vpodlesnyi/eGAN-FET-module/README.md

# eGAN-FET-module
Control driver module with implemented Gallium Nitride MOSFET transistors.
