vpodlesnyi/eGAN-FET-module/OUTPUT/BOM/Bill of Materials-eGAN-FET-module.xlsx

Part Name | Part Number | Value | Voltage | Quantity | Total | 2 | Ordered
Ceramic | GRM31C5C2A104JA01L | 0,1мк | 100В | 3 | 6 |  | 10
Ceramic | GRM155R71H104KE14D | 0,1мк | 50В | 22 | 44 |  | 100
Ceramic | GRM1555C1H102J | 1000 | 50B | 4 | 8 |  | 100
MLCC | EMK105BJ105KV-F | 1мк | 16B | 12 | 24 |  | 100
Bidirectional, Ultra-Precise Current Sense Amplifier | INA240A1D |  |  | 4 | 8 |  | 8
Low-Drift, Low-Power, Dual-Output, Voltage References | REF1933AIDDCT |  |  | 3 | 6 |  | 6
Half Bridge GaN Driver with Integrated Bootstrap Diode | LMG1205YFXR |  |  | 4 | 8 |  | 8
Resistor | RC0402FR-07100KL | 100к |  | 1 | 2 |  | 100
Current Sense Resistors | CRE2512-FZ-R003E-3 | 0.003 |  | 6 | 12 |  | 12
Current Sense Resistors | ERJ-8CWFR036V | 0.036 |  | 1 | 2 |  | 5
Resistor | RC0402FR-079K1 | 9,1к |  | 1 | 2 |  | 100
Resistor | RC0402FR-071KL | 1к |  | 4 | 8 |  | 100
Resistor | RC0402FR-07100RL | 100 |  | 14 | 28 |  | 100
Resistor | RC0402FR-0710KL | 10к |  | 14 | 28 |  | 100
Resistor | RC0402FR-075R1L | 5,1 |  | 7 | 14 |  | 100
Resistor | RC0402FR-071RL | 1 |  | 7 | 14 |  | 100
Resistor | RC0402FR-070RL | 0 |  | 2 | 4 |  | 100
General Purpose Diodes | 1N4448WQ-7-F |  |  | 1 | 2 |  | 5
 | EPC2016C |  |  | 7 | 14 |  | 8 | 6 с элитана | 2 с чип дипа
 | PMCXB900UELZ |  |  | 7 | 14 |  | 14
PLS-2 |  |  |  | 7 | 14
3 отверстия под запайку |  |  |  | 4 | 8
PLS-3 | DS1021-1*3SF112-B |  |  | 3 | 6
Resistor | RC0402FR-076K8 | 6,8к |  | 1 | 2 |  | 100
