vpodlesnyi/eGAN-FET-module/OUTPUT/STEP/eGAN-FET-module.step

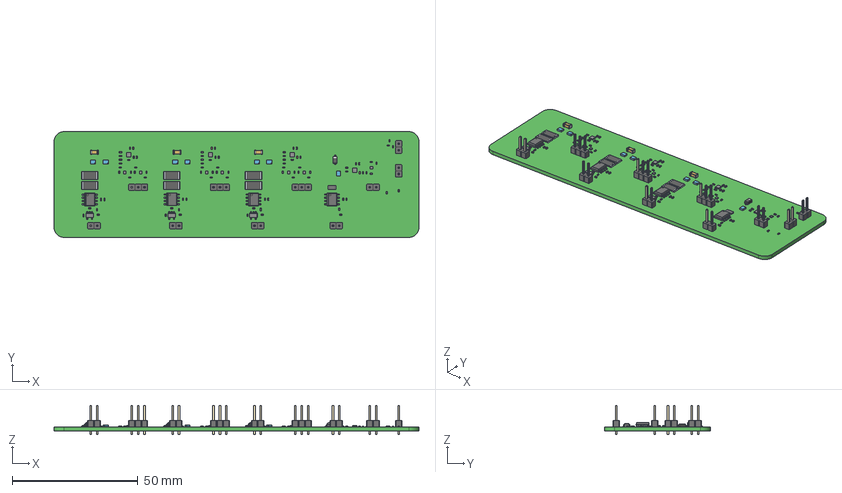
[picture p1: CAD file, 2022-06-16]
OUTPUT/STEP/eGAN-FET-module.step
145.0 x 42.0 x 11.5 mm
User_Library-PLS-2 x 7
User_Library-PLS-3 x 3
User_Library-R_0402 x 50
PMCXB900UELZ x 7
Extruded x 7
CircuitWorks-SOD123
User_Library-R2512-1 x 6
User_Library-res1206-1
SOIC-8 x 4
User_Library-SOT23-5-3_Free-Models003 x 3
User_Library-SOT23-5-3_Fusion x 3
User_Library-C0402-1 x 38
SMD_1206 x 3
