vpodlesnyi/eGAN-FET-module/OUTPUT/SCH/eGAN-FET-module.PDF

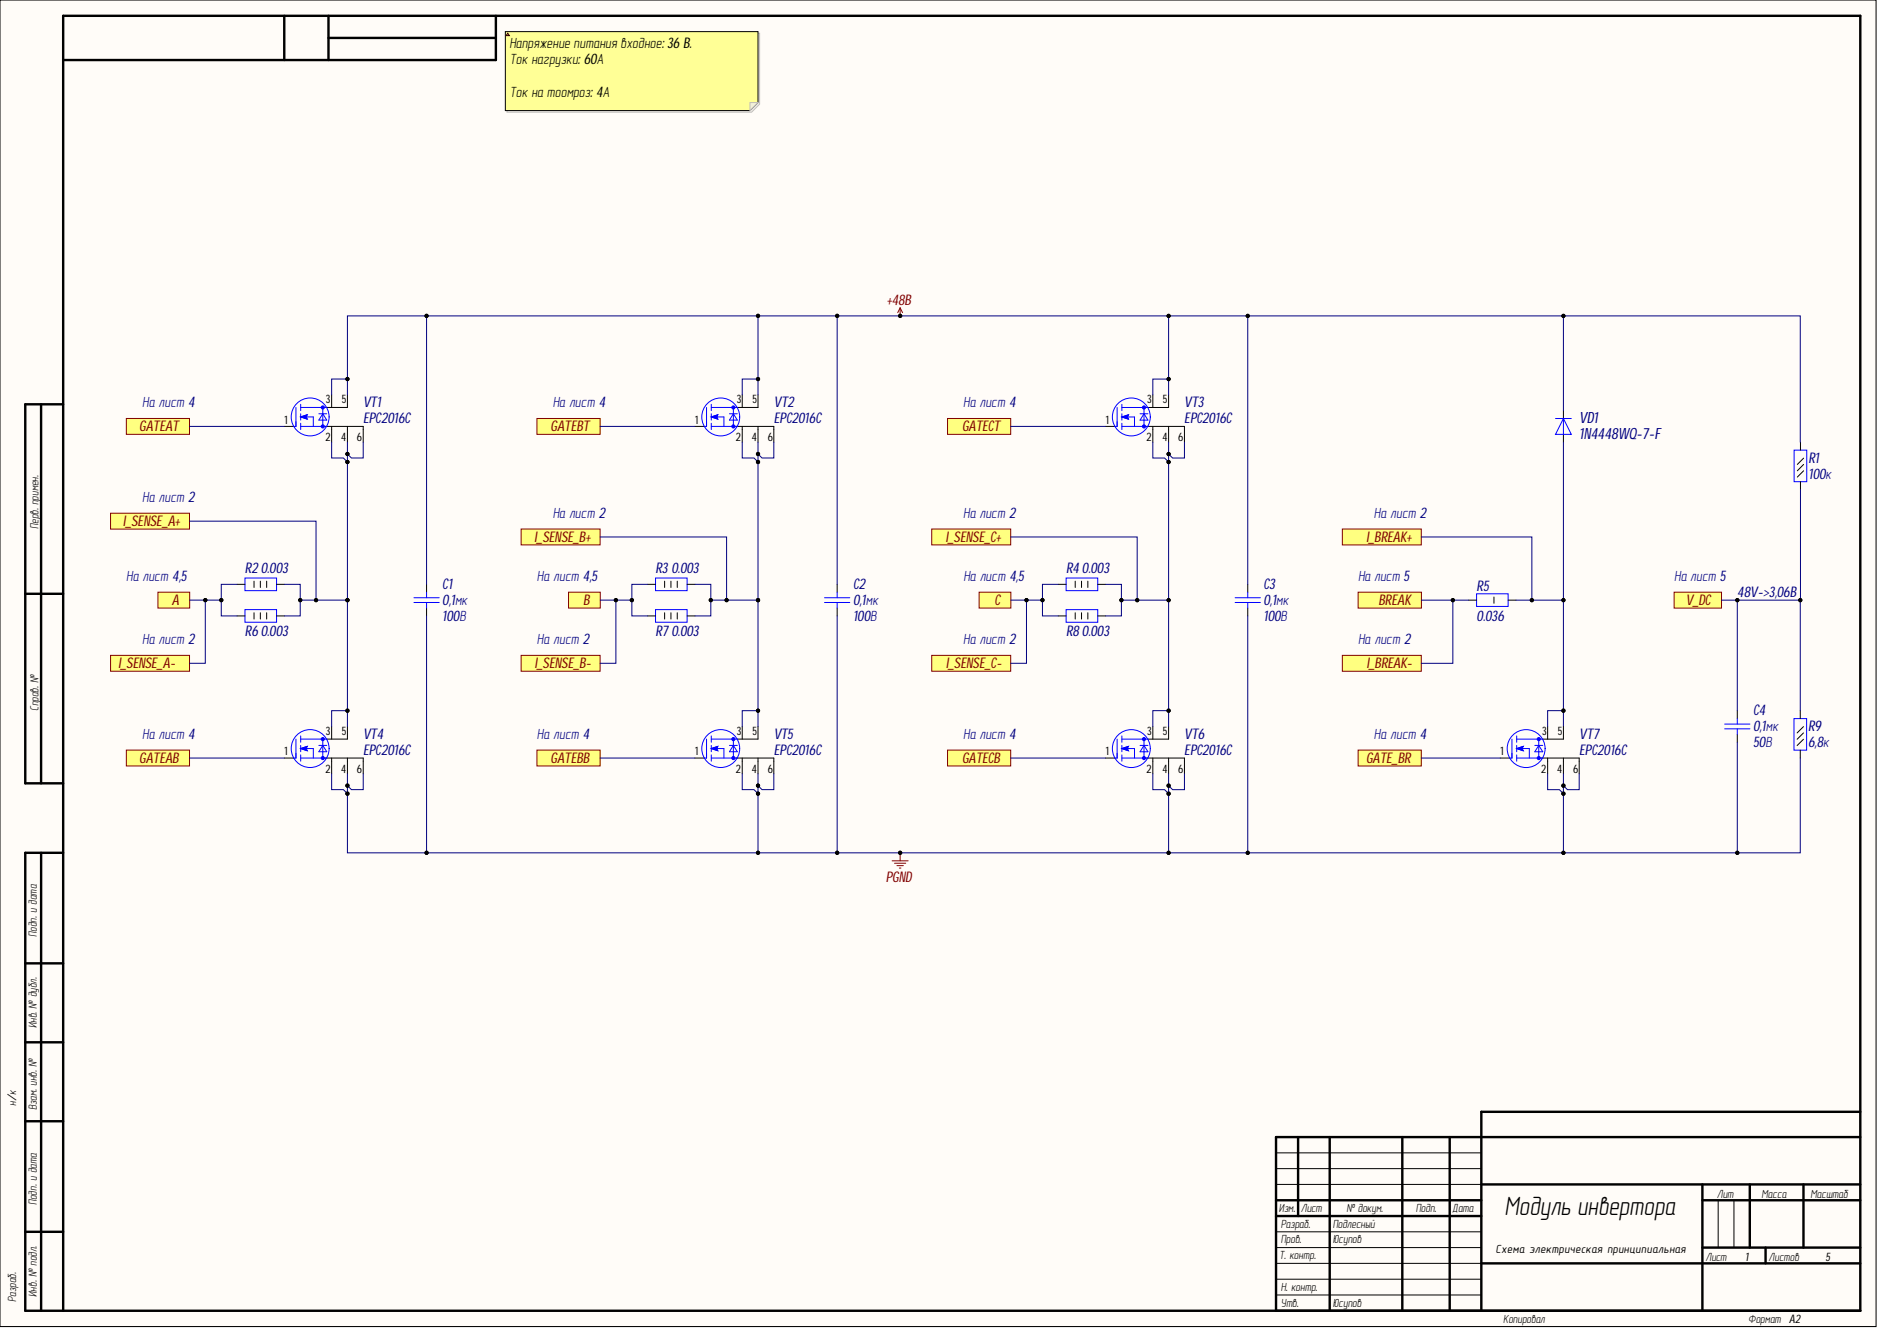
[picture p2: page 1]

Инв. № подл. Инв. № дубл. Подп. и дата Взам. инв. № Подп. и дата Перв. примен. Справ. №

Изм . | Лис т | № докум . | Подп . | Дат а | | | ит | Масса | Масштаб 1

Модуль инвертора Схема электрическая принципиальная | Л

Разраб . | | Подлесный
Пров . | | Юсупов
Т. контр . | | | | | Лис т | Листов

Н. контр .
Утв . | Юсупов

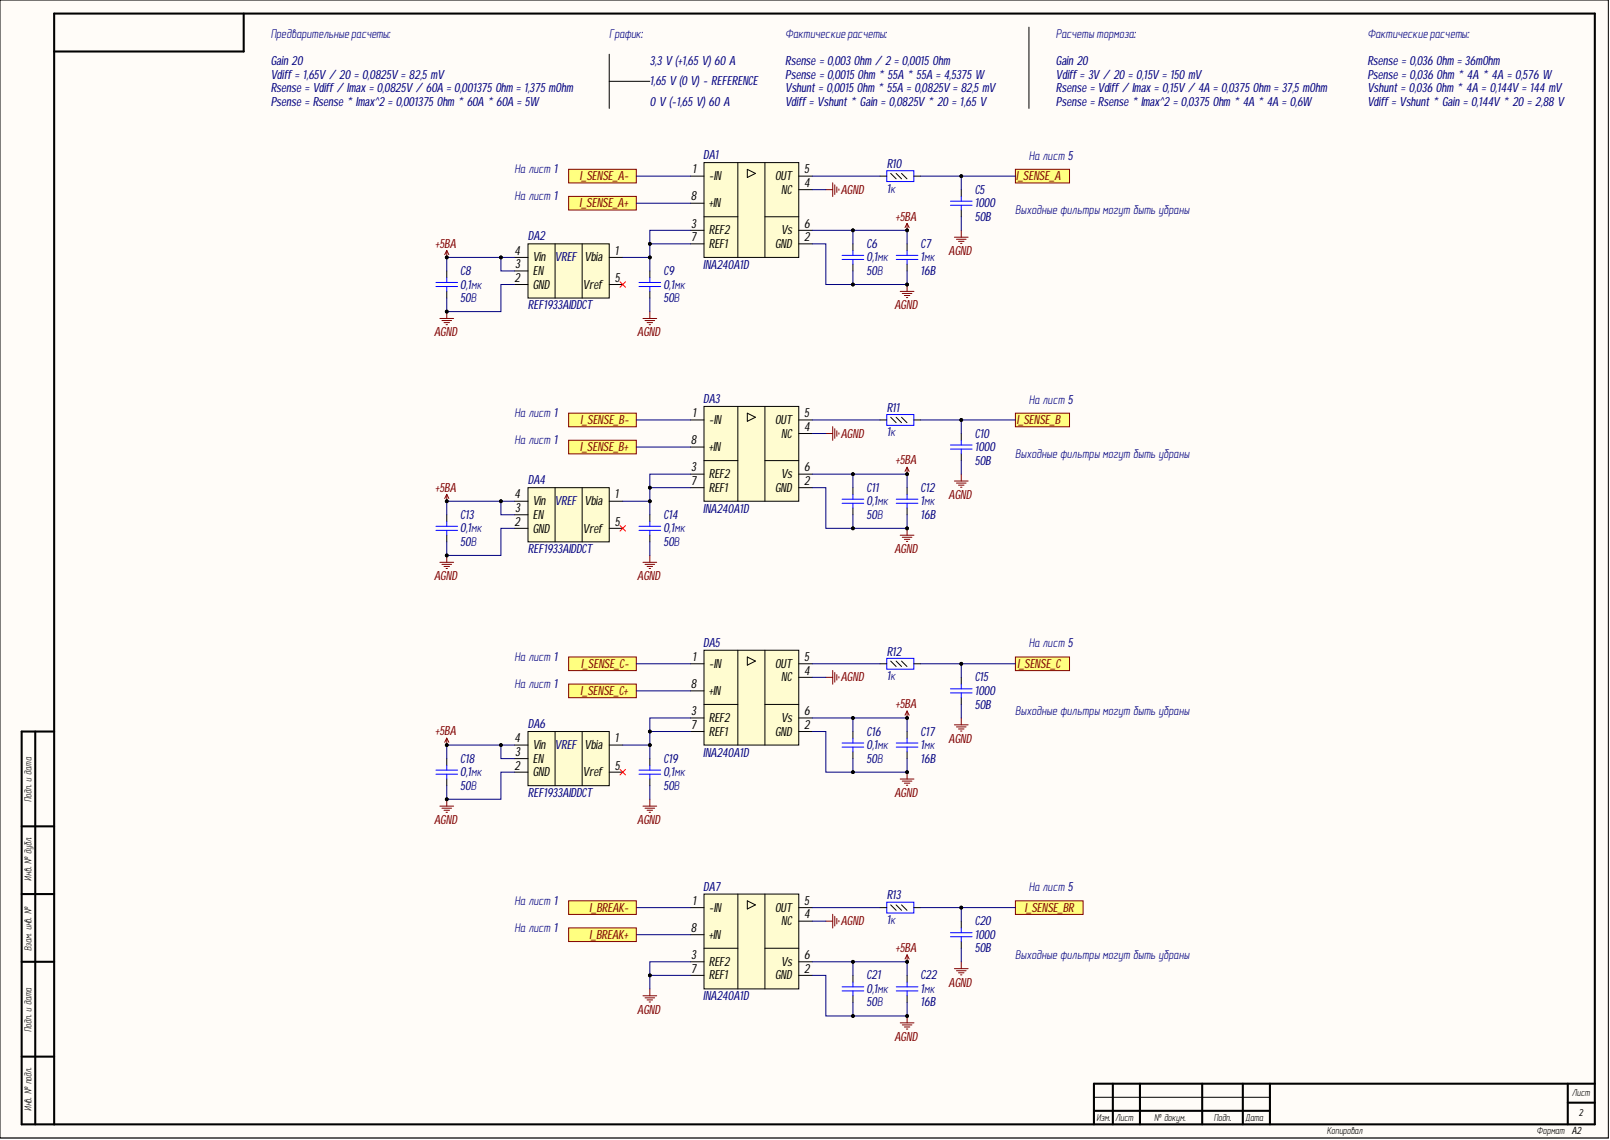
[picture p3: page 2]

Gain 20
Vdiff = 1,65V / 20 = 0,0825V = 82,5 mV
Rsense = Vdiff / Imax = 0,0825V / 60A = 0,001375 Ohm = 1,375 mOhm

Vdiff = 3V / 20 = 0,15V = 150 mV
Rsense = Vdiff / Imax = 0,15V / 4A = 0,0375 Ohm = 37,5 mOhm
Psense = Rsense * Imax^2 = 0,0375 Ohm * 4A * 4A = 0,6W

DA1 | На лист 5
-IN 1

Выходные фильтры могут быть убраны

Инв. № подл. Инв. № дубл. Подп. и дата Взам. инв. №

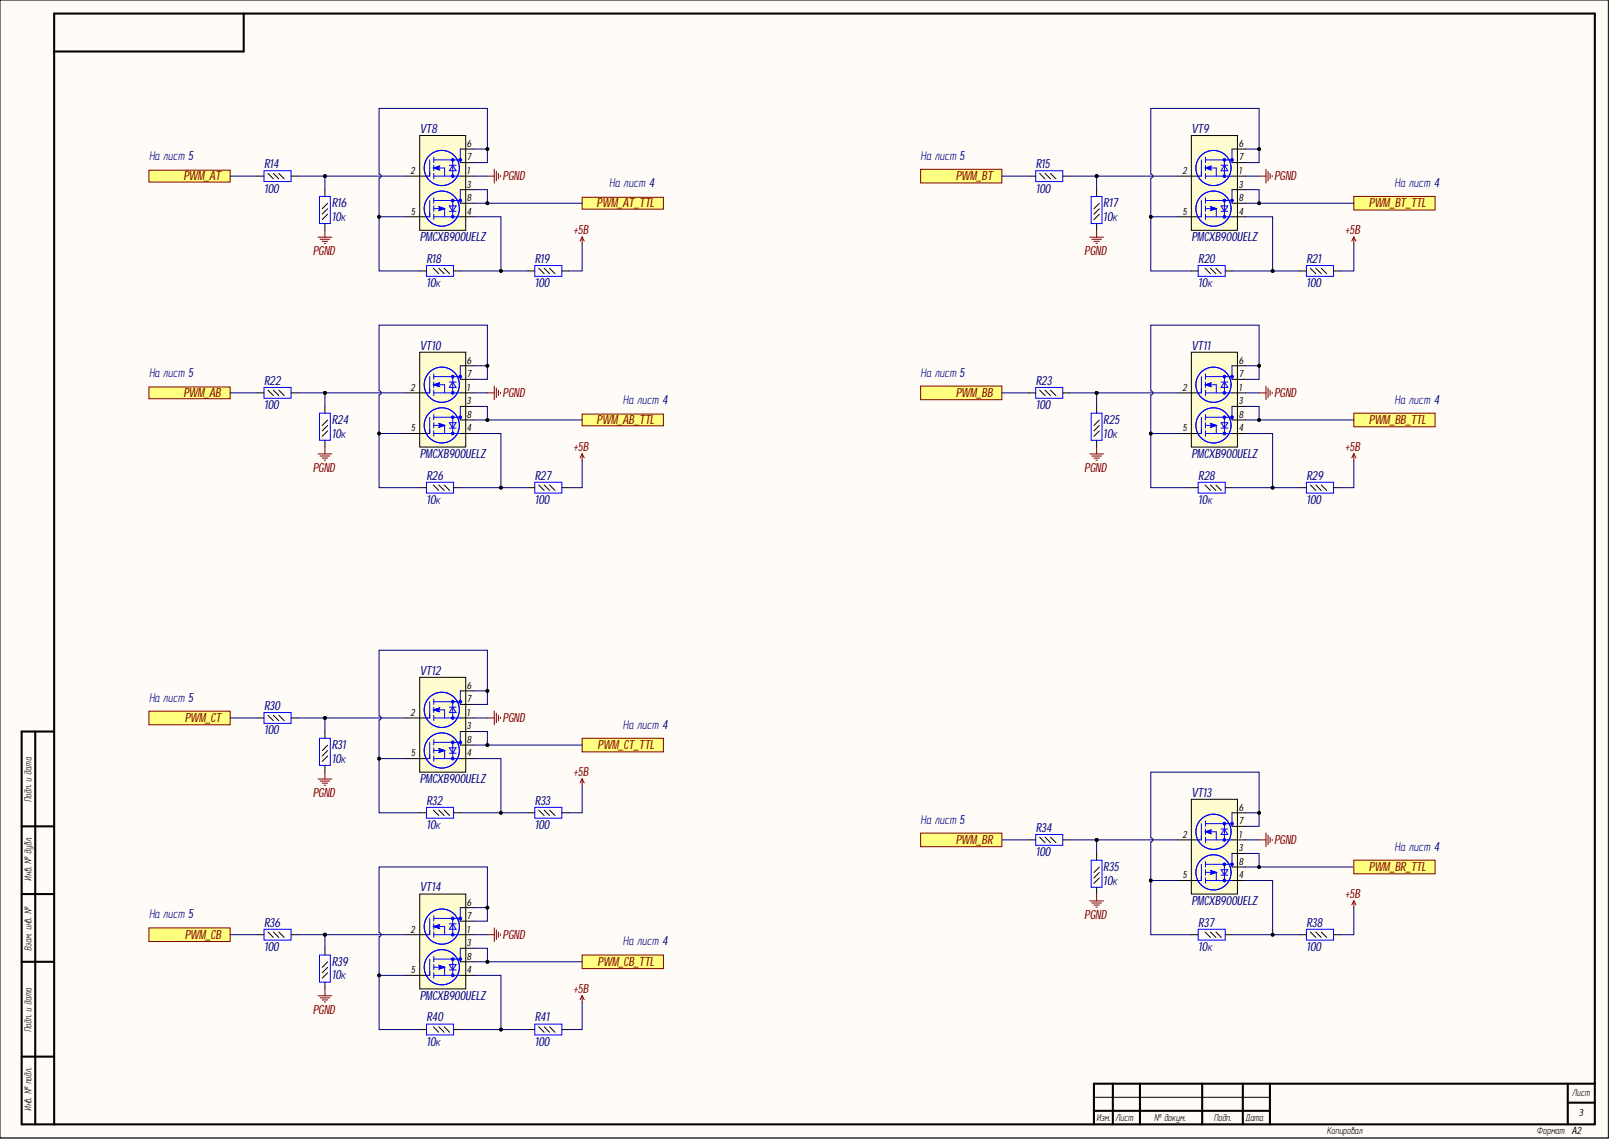
[picture p4: page 3]

Инв. № подл. Инв. № дубл. Подп. и дата Взам. инв. №

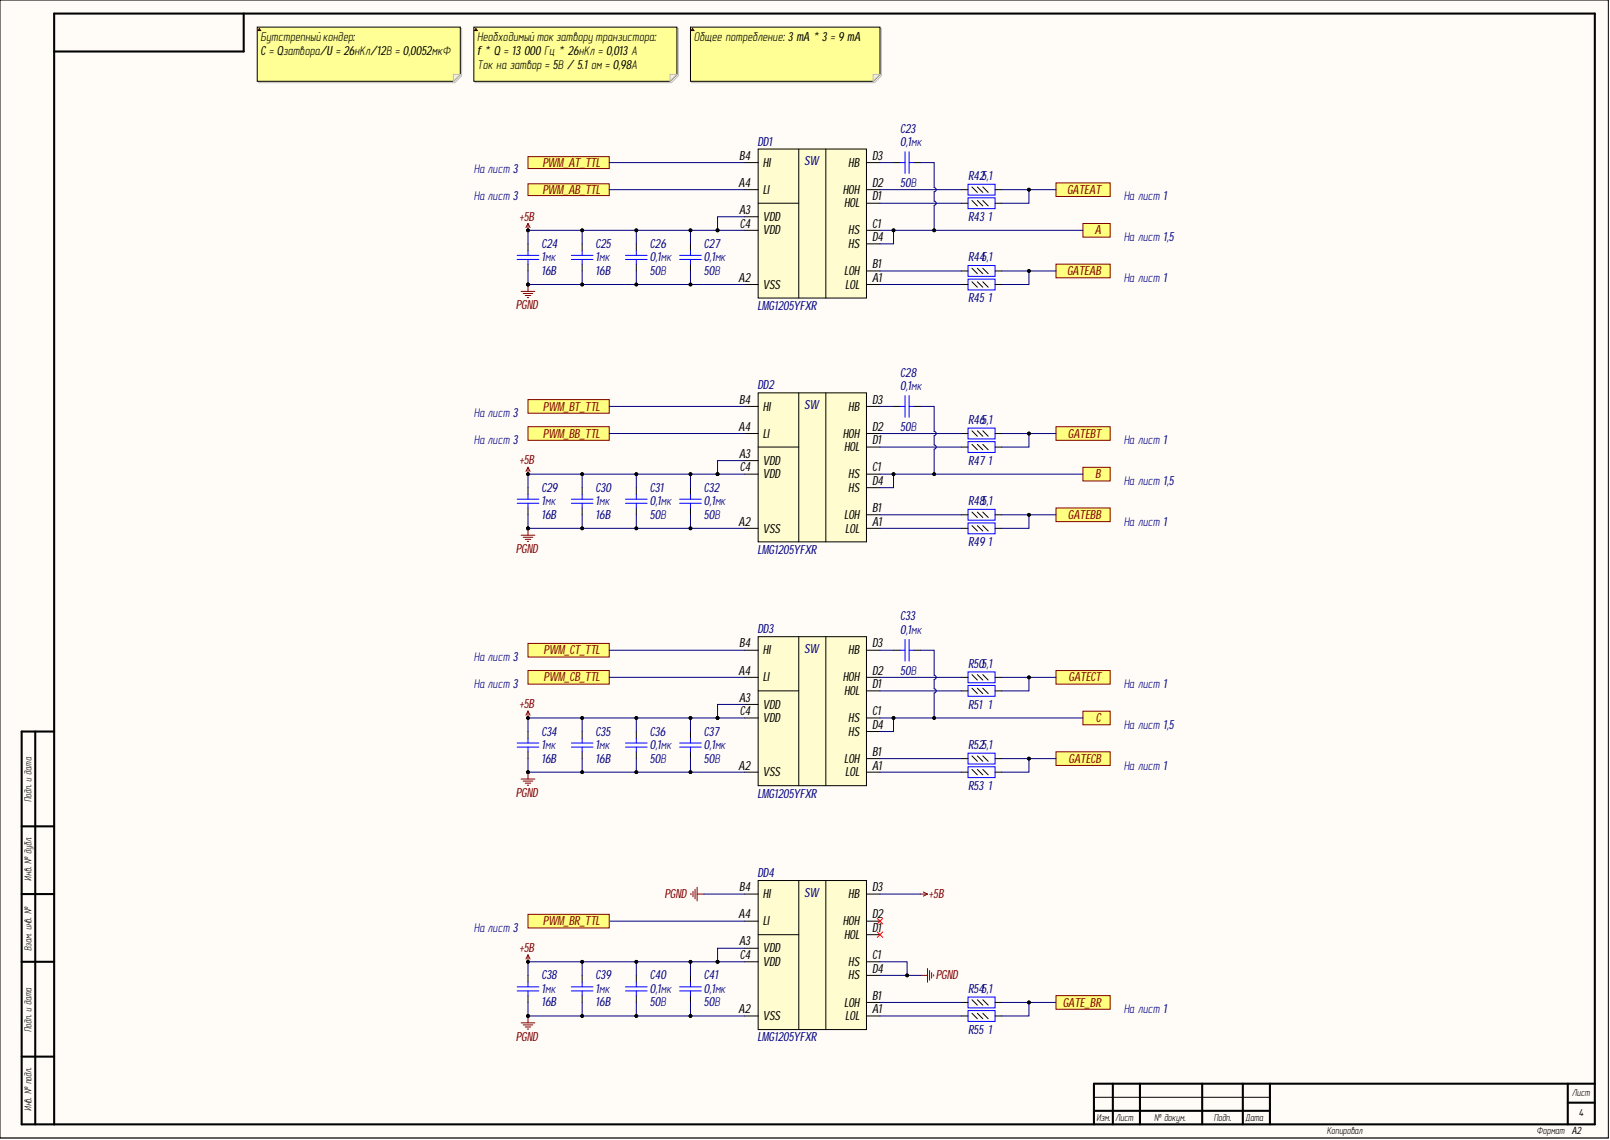
[picture p5: page 4]

Необходимый ток затвору транзистора:
f * Q = 13 000 Гц * 26нКл = 0,013 А
Ток на затвор = 5В / 5.1 ом = 0,98А

Общее потребление: 3 mA * 3 = 9 mA

HI B4 | SW | HS | D4 VDD C4

Инв. № подл. Инв. № дубл. Подп. и дата Взам. инв. №

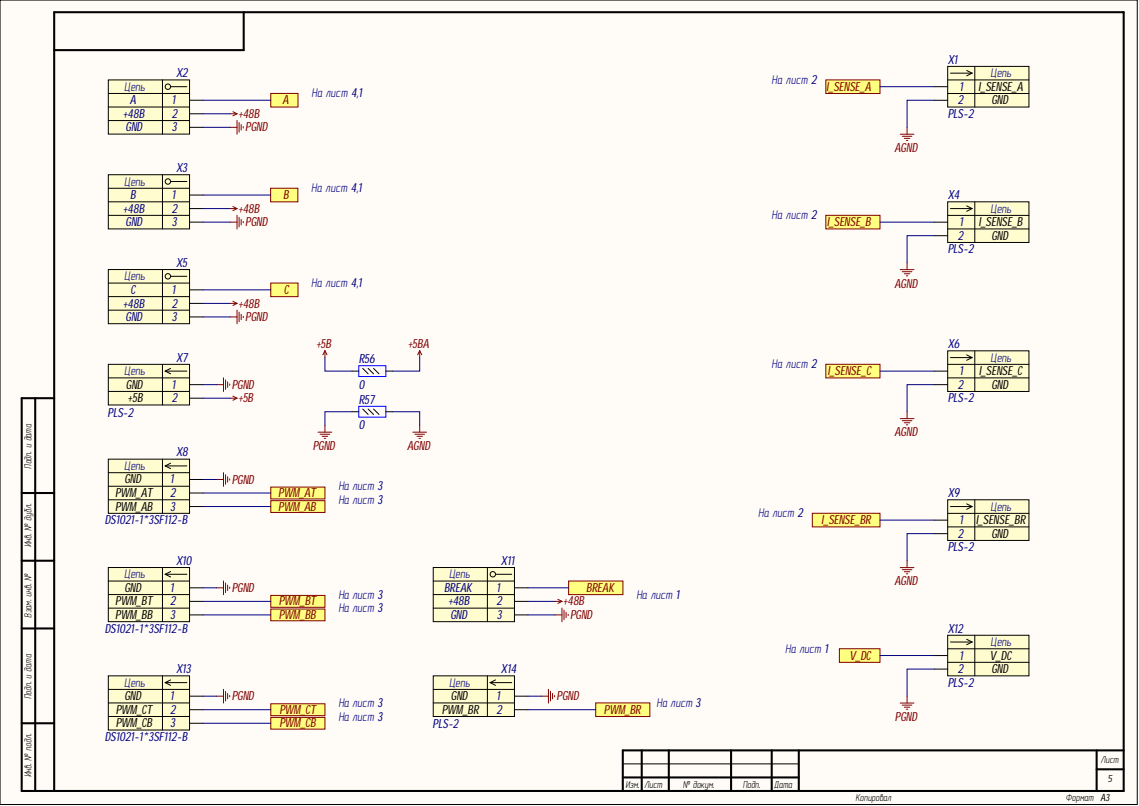
[picture p6: page 5]

Цепь

+48B | 2
GND | 3

GND | 1

Инв. № подл. Инв. № дубл. Подп. и дата Взам. инв. №

1 | I_SENSE_BR
2 | GND
