vpodlesnyi/eGAN-FET-module/(list of files, drawings)

Other design files:
eGAN-FET-module.PrjPcb
SCH/eGAN-FET-module_Amplifier.SchDoc
SCH/eGAN-FET-module_Bridge.SchDoc
SCH/eGAN-FET-module_Connectors.SchDoc
SCH/eGAN-FET-module_Driver.SchDoc
SCH/eGAN-FET-module_Logic.SchDoc
