vpodlesnyi/eGAN-FET-module/(commit log)

2022-06-12 Cпроектировал схему драйвера. Вставил транзистор. Сделал преобразователь уровня. Начал усилительную цепь.
    [eGAN-FET-module.PrjPcb, eGAN-FET-module_Amplifier.SchDoc, eGAN-FET-module_Bridge.SchDoc, eGAN-FET-module_Connectors.SchDoc, eGAN-FET-module_Driver.SchDoc, eGAN-FET-module_Logic.SchDoc]
2022-06-13 Завершил схему.
    [eGAN-FET-module.PrjPcb, eGAN-FET-module_Amplifier.SchDoc, eGAN-FET-module_Bridge.SchDoc, eGAN-FET-module_Connectors.SchDoc, eGAN-FET-module_Driver.SchDoc, eGAN-FET-module_Logic.SchDoc]
2022-06-13 Добавил тормоз в схему.
    [eGAN-FET-module.PrjPcb, eGAN-FET-module_Amplifier.SchDoc, eGAN-FET-module_Amplifier1.SchDoc, eGAN-FET-module_Bridge.SchDoc, eGAN-FET-module_Connectors.SchDoc, eGAN-FET-module_Driver.SchDoc, eGAN-FET-module_Logic.SchDoc]
2022-06-15 Завершил трассировку. Добавил папки для выходной документации.
    [Bill of Materials-eGAN-FET-module.xlsx, eGAN-FET-module.PrjPcb, eGAN-FET-module.step, eGAN-FET-module_Amplifier.SchDoc, eGAN-FET-module_Amplifier1.SchDoc, eGAN-FET-module_Bridge.SchDoc, eGAN-FET-module_Connectors.SchDoc, eGAN-FET-module_Driver.SchDoc]
2022-06-16 Заказал плату в резоните.
    [eGAN-FET-module.step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]
2022-06-21 Учел правила резонита.
    [eGAN-FET-module.PrjPcb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]
2022-06-21 Поправил припуск маски.
    [eGAN-FET-module.GBL, eGAN-FET-module.GBO, eGAN-FET-module.GBS, eGAN-FET-module.GM1, eGAN-FET-module.GTL, eGAN-FET-module.GTO, eGAN-FET-module.GTS]
